EMajesty/dl4-mods/readme.md

# 📡 DL4 Mods 📡

<br>

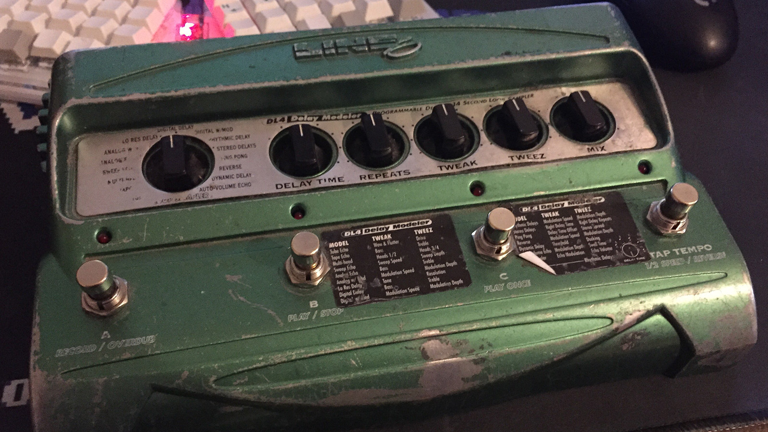
[picture p1: pictures/vanilla.jpg]
vanilla


<br>

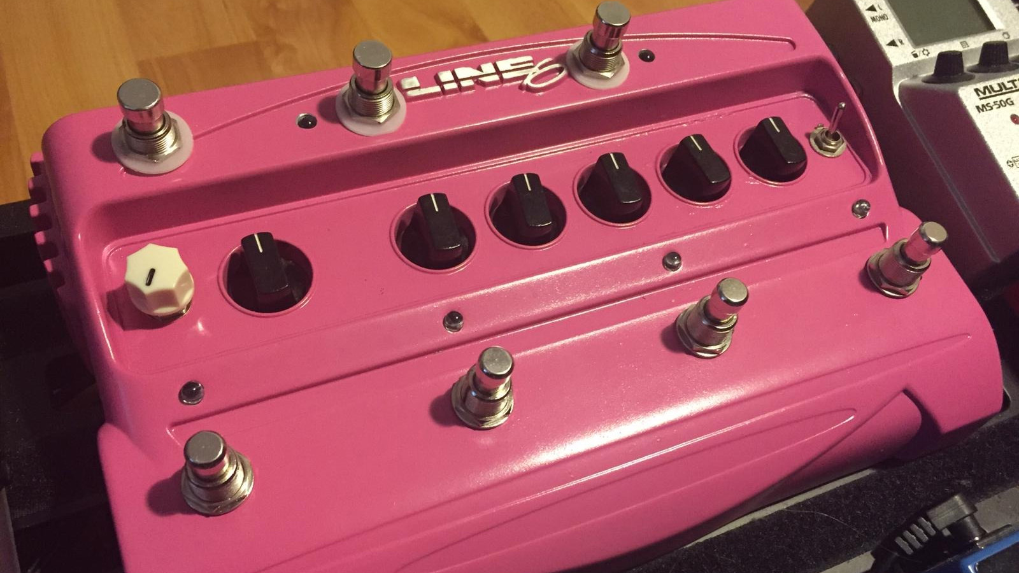
[picture p2: pictures/dl4.jpg]
dl4


<br>

# 🧨 Disassembly

<br>

Remove the potentiometer knobs by pulling or carefully prying with a flathead screwdriver.

Undo the jack nuts.

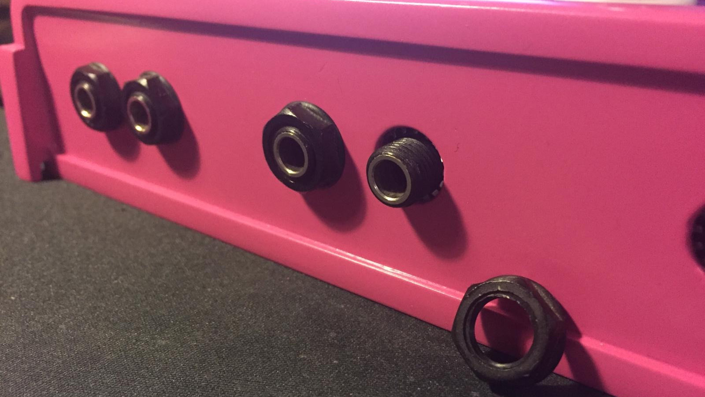
[picture p3: pictures/jacks.jpg]
jack nuts


Unscrew the five screws on the bottom.

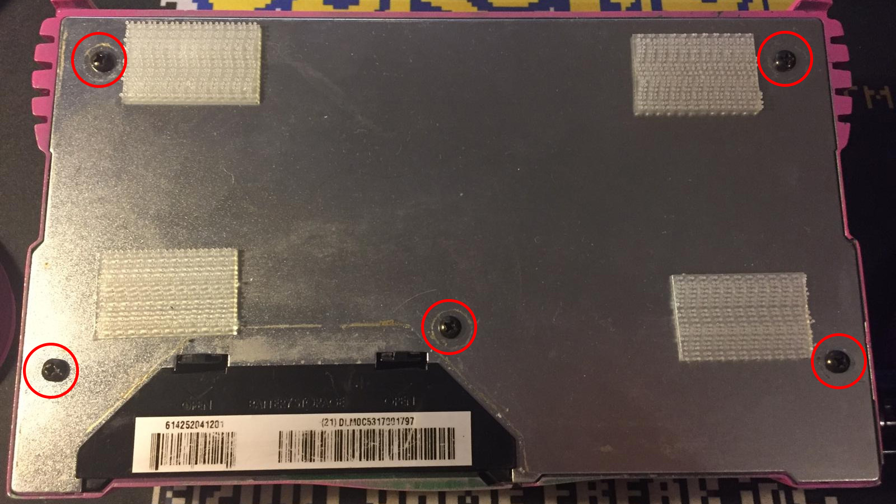
[picture p4: pictures/bottom.jpg]
bottom


Remove the four screws and the hex standoff.

Desolder the battery cables and remove the battery contacts to make room for the external tap tempo jack and the expression knob.

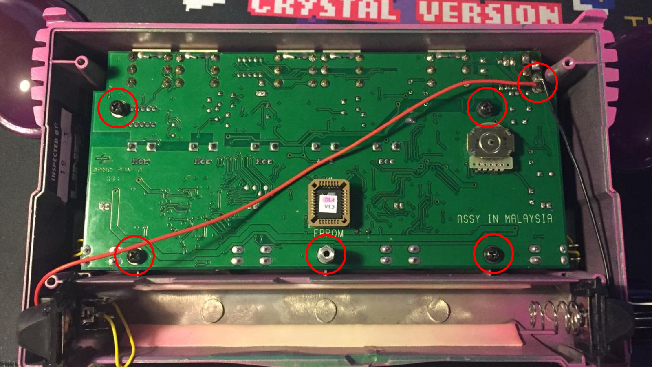
[picture p5: pictures/disassembly4.jpg]
dis4


Lift the PCB out by the front (standoff side) edge.

<br>

# 🔩 Switch Replacement

<br>

Replace the flimsy original switches with heavier duty ones.

<br>

| Parts needed | Qty |
| --- | --- |
| Momentary SPST footswitch | 4 |

<br>

Desolder or destroy the original tactile switches. Be careful not to lift a solder pad or cut a trace.

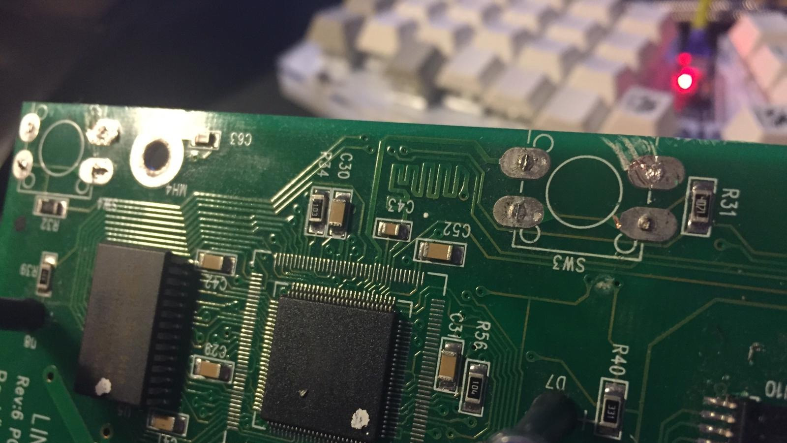
[picture p6: pictures/switches5.jpg]
fs


Remove the old switch bodies by undoing the nut on the outside.

Remove nubs in switch holes with e.g. a file, rotary tool or a 12mm / 1/2" drill bit.

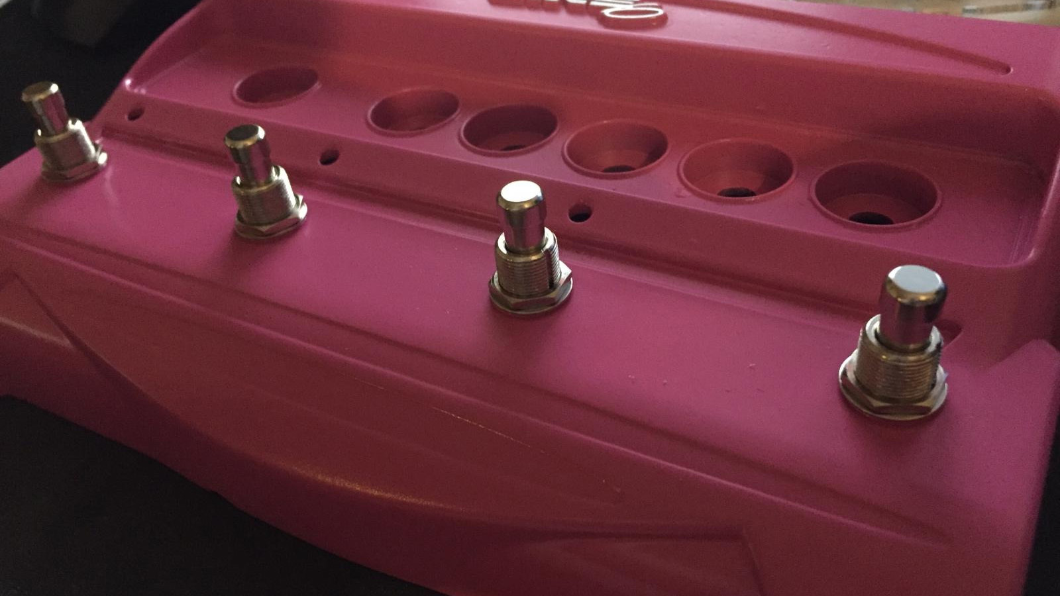
[picture p7: pictures/switches1.jpg]
switches1


Install the switches without the nut or washers on the inside.

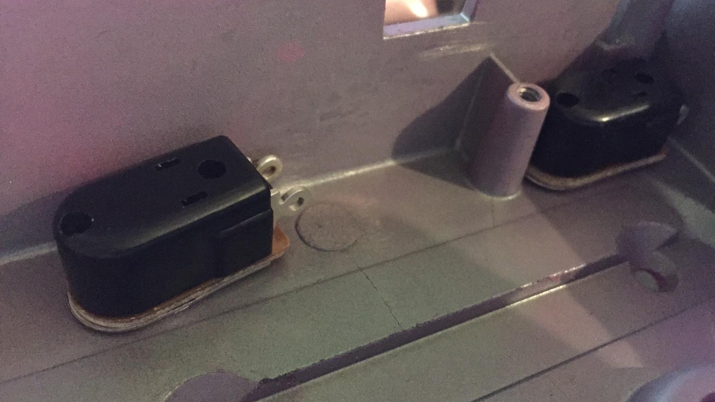
[picture p8: pictures/switches2.jpg]
switches2


Wire the new switches to the pads of the tactile switches, one wire on either of the top pads, one wire on a bottom pad. (The top pads are connected to each other and so are the bottom ones)

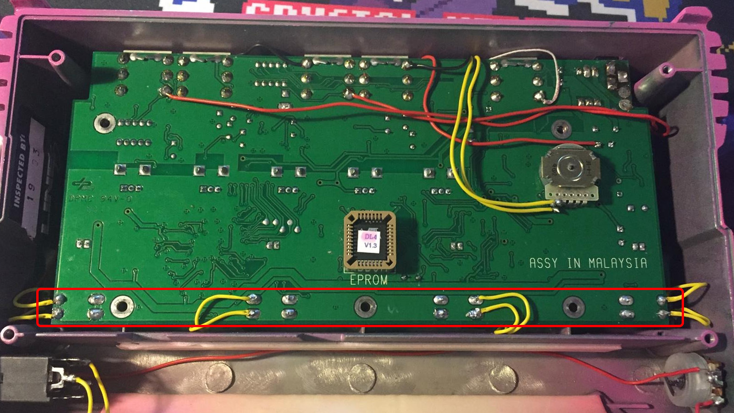
[picture p9: pictures/switches4.jpg]
sw4


<br>

# 💡 Led Replacement

| Parts needed | Qty |
| --- | --- |
| 3mm/5mm LEDs | 4 |

<br>

Desolder the old LEDs.

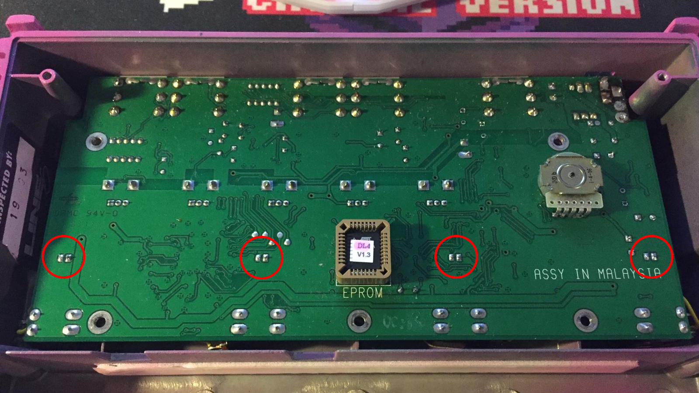
[picture p10: pictures/leds1.jpg]
leds1


Using the spacers from the old LEDs, install the new LEDs aligning the longer leg of the LED with the + on the PCB.

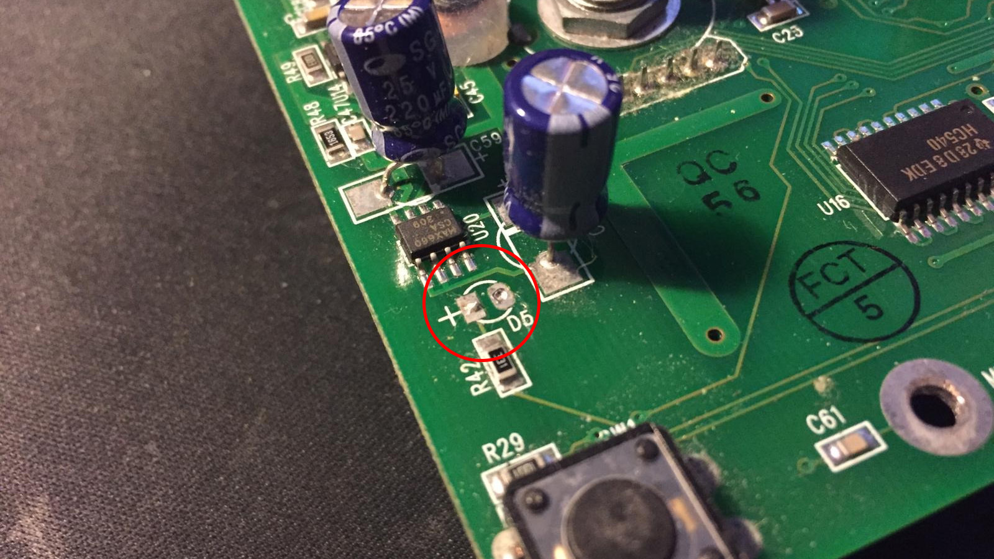
[picture p11: pictures/leds2.jpg]
leds2


If using 5mm LEDs you might have to drill the holes in the enclosure to match.

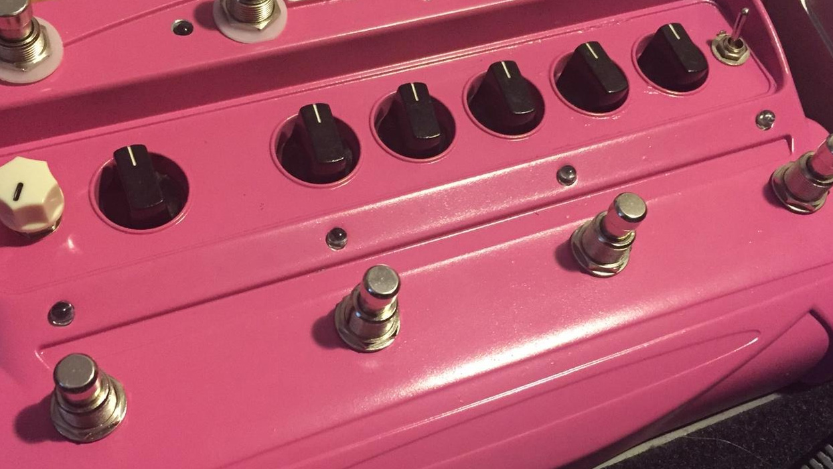
[picture p12: pictures/leds3.jpg]
leds3


<br>

# 📚 Double Presets Footswitch

[Source](https://www.diystompboxes.com/smfforum/index.php?topic=59261.0)

<br>

This mod adds a second set of presets by acting like an expression pedal in full heel or toe position.

<br>

| Parts needed | Qty |
| --- | --- |
| Latching DPDT footswitch | 1 |
| 10K resistor | 1 |

<br>

| Optional | Qty |
| --- | --- |
| LED | 1 |
| LED holder | 1 |

<br>

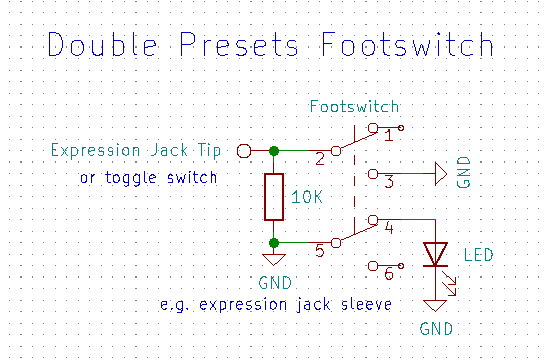
[picture p13: pictures/doublepresetschem.png]
doublepresetschem


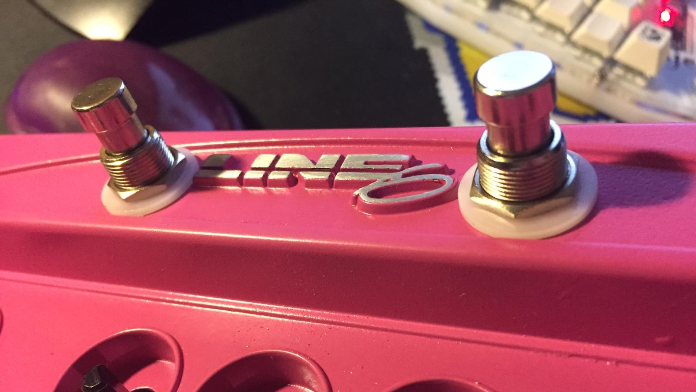
[picture p14: pictures/switches3.jpg]
switches3


Marking the holes is easier if you fit the white footswitch washer that comes with most 3PDT switches in the recess, then find the center. This way the switches shouldn't conflict with the jacks.

You might have to resolder C15 flat if it touches the switch.

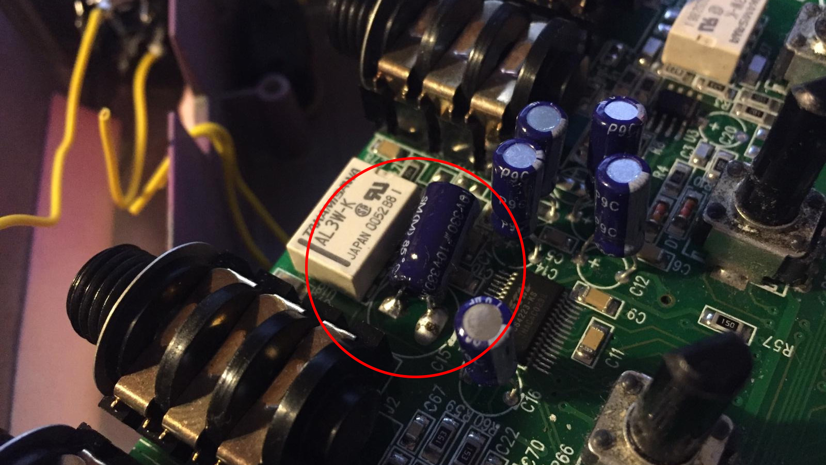
[picture p15: pictures/cap.jpg]
cap


Somebody somewhere said one should isolate the switching tip contact of the expression pedal jack, for example by sticking tape between the contacts. 

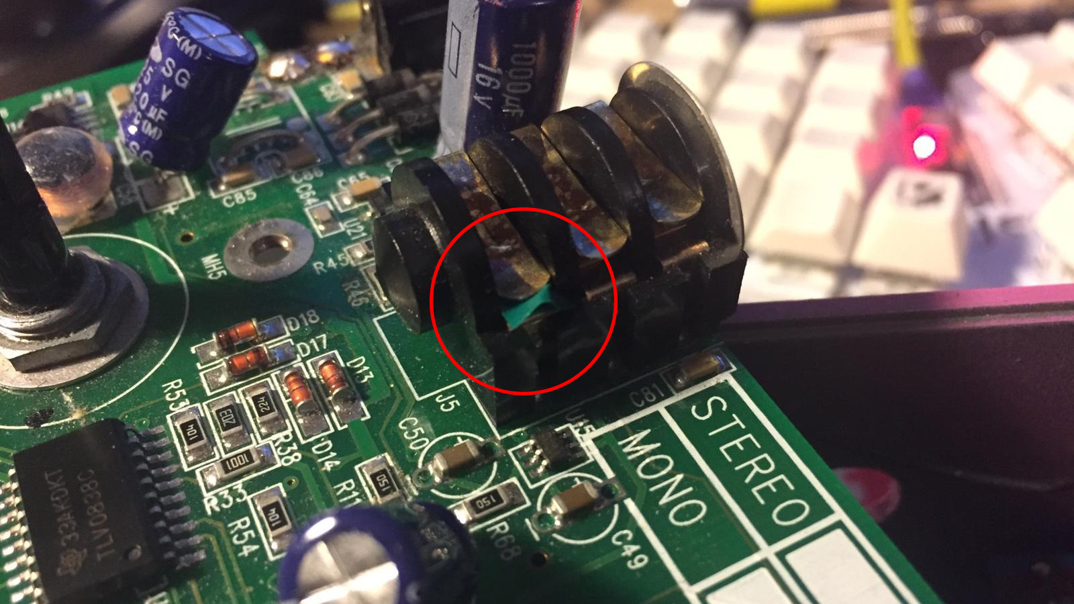
[picture p16: pictures/expisolate.jpg]
expisolate


If you're not using the toggle switch to choose between double presets / expression knob, solder the wire from the footswitch to the expression jack tip.

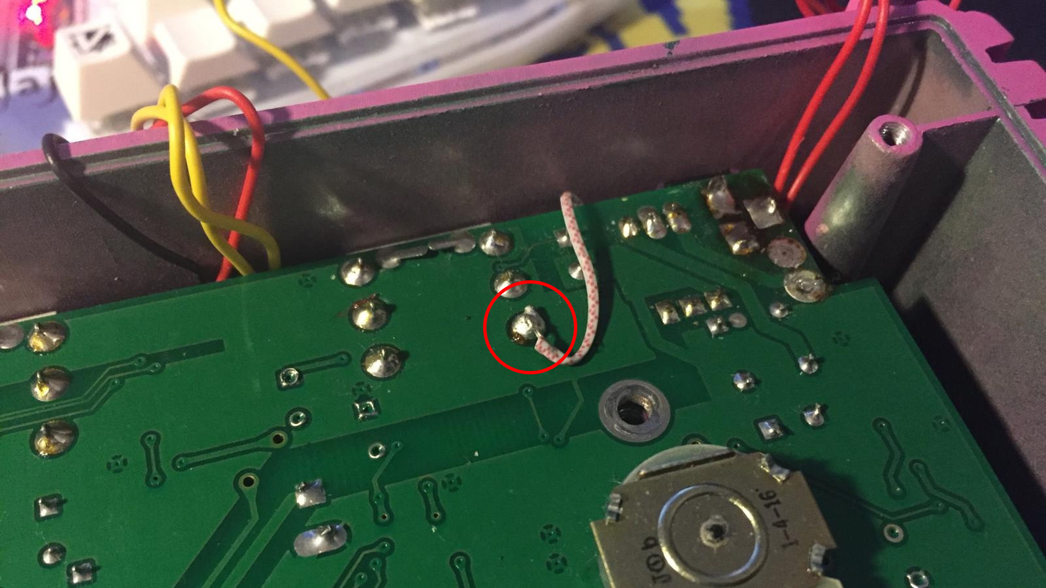
[picture p17: pictures/exptip.jpg]
exptip


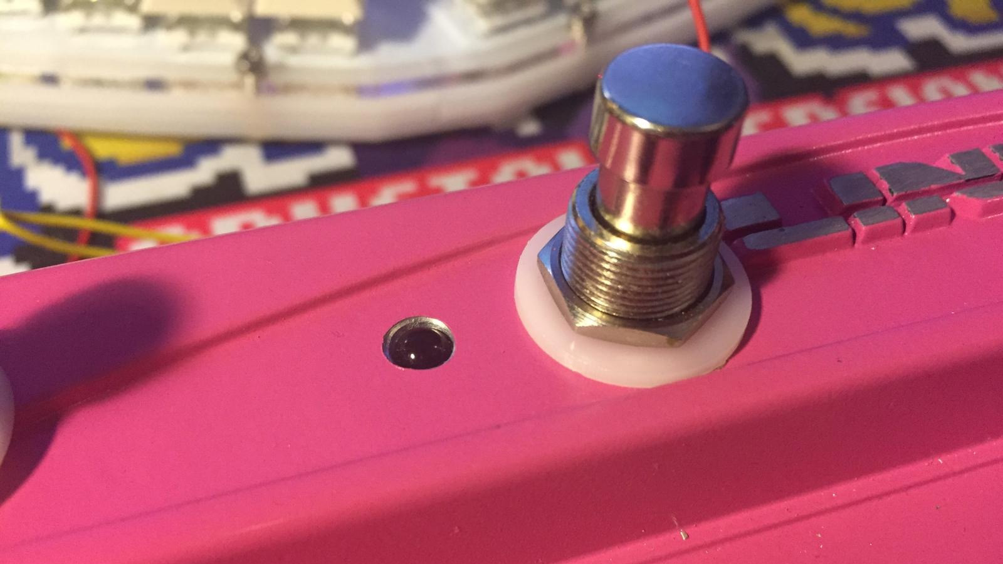
[picture p18: pictures/footled.jpg]
footled


You can solder the wire marked 'Expression Jack Sleeve' to any of these points.

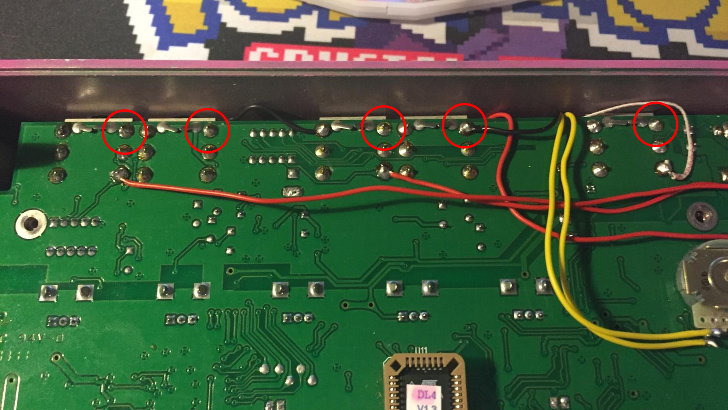
[picture p19: pictures/gnd.jpg]
gnd


<br>

# 💨 Expression Knob

[Source](https://web.archive.org/web/20201101212542/https://www.madbeanpedals.com/forum/index.php?topic=14394.msg134258)

<br>

The expression knob works like an external expression pedal would.

<br>

| Parts needed | Qty |
| --- | --- |
| 10K linear potentiometer | 1 |
| Potentiometer knob | 1 |

<br>

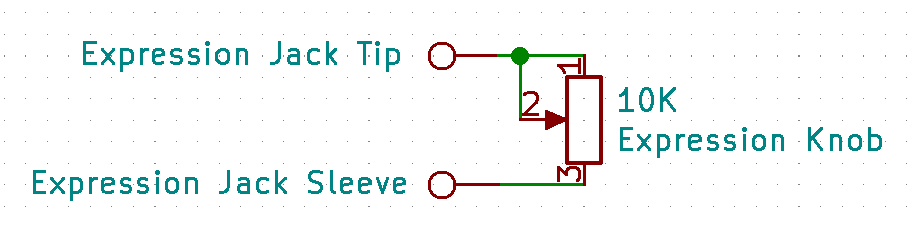
[picture p20: pictures/expressionknob.png]
expressionknob


Drill a hole for the potentiometer on an end of the battery bay approx. 20mm from the front edge and 18mm from the bottom, or whatever dimensions suit your knob.

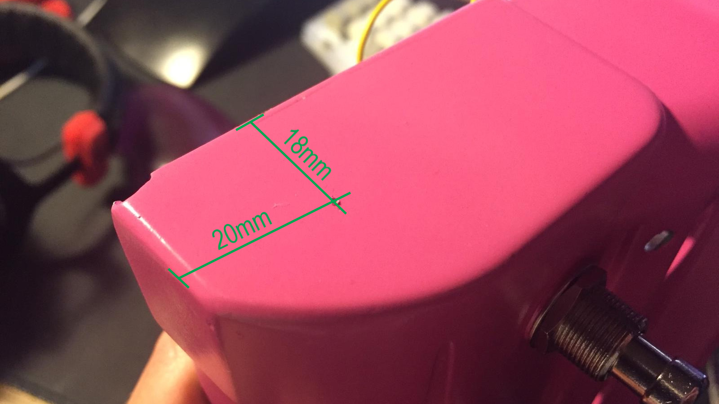
[picture p21: pictures/expknob1.jpg]
expknob


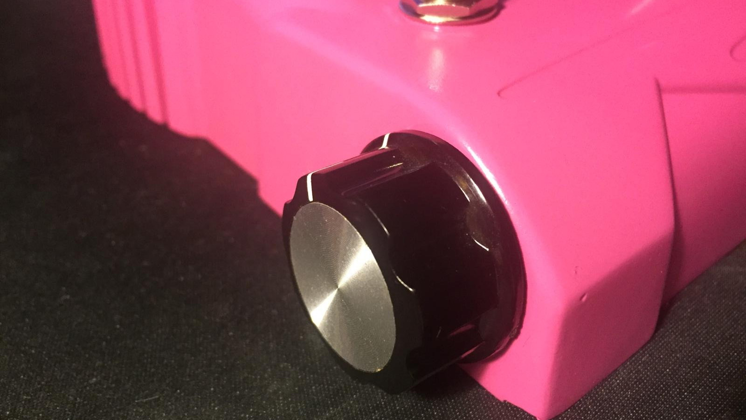
[picture p22: pictures/expknob2.jpg]
expknob2


Somebody somewhere said one should isolate the switching tip contact of the expression pedal jack, for example by sticking tape between the contacts. 

expisolate

If you're not using the toggle switch to choose between double presets / expression knob, solder the wire from the potentiometer to the expression jack tip.

exptip

You can wire the ground to a bottom pad of a switch.

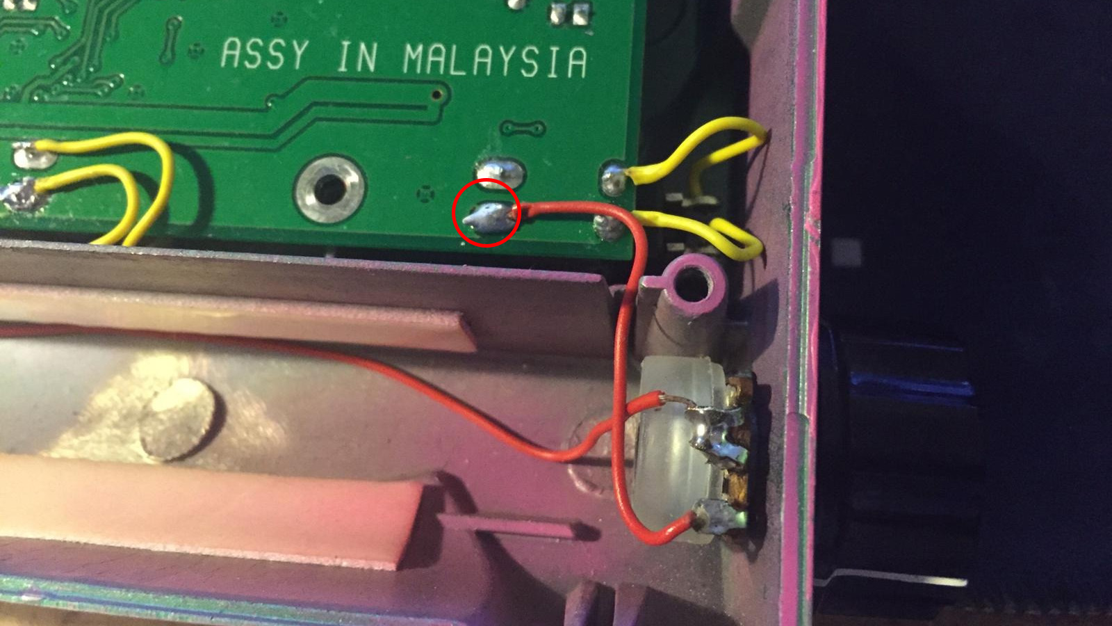
[picture p23: pictures/expknob3.jpg]
expgnd


<br>

# 💱 Switching between double presets and expression knob

<br>

| Parts needed | Qty |
| --- | --- |
| SPDT toggle switch | 1 |

<br>

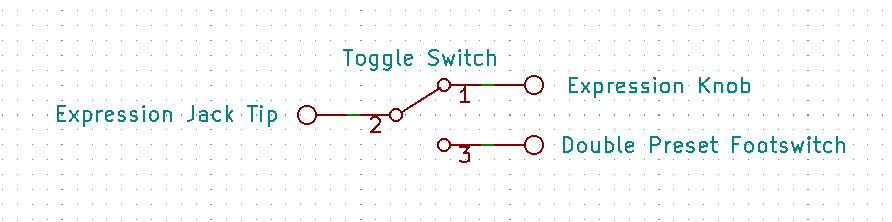
[picture p24: pictures/toggleschem.png]
toggleschem


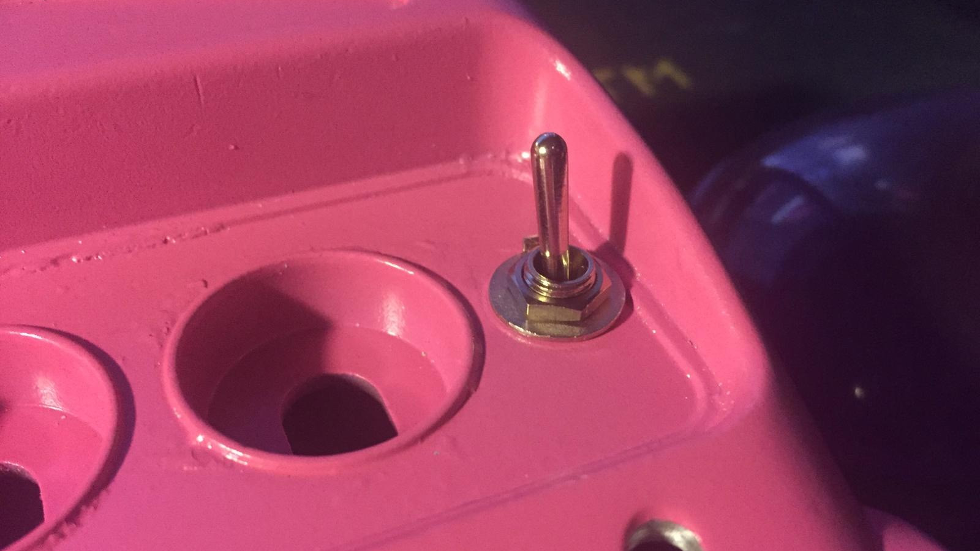
[picture p25: pictures/switch1.jpg]
switch1


Solder the wire from the toggle switch to the expression jack tip.

exptip

<br>

# 🎶 External Tap Tempo
[Source](https://web.archive.org/web/20110130235011/http://kyleagee.com/?page_id=105)

<br>

The external tap tempo jack allows you to connect a separate switch box via a cable.

<br>

| Parts needed | Qty |
| --- | --- |
| Mono jack | 1 |

<br>

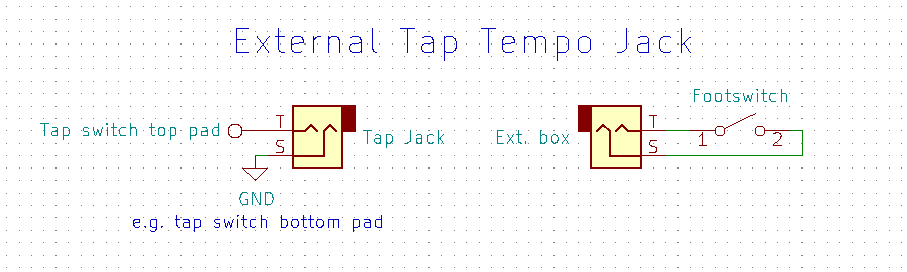
[picture p26: pictures/externaltap.png]
externaltap


Drill a hole for the jack on the end of the battery bay approx. 20mm from the front edge and 14mm from the bottom

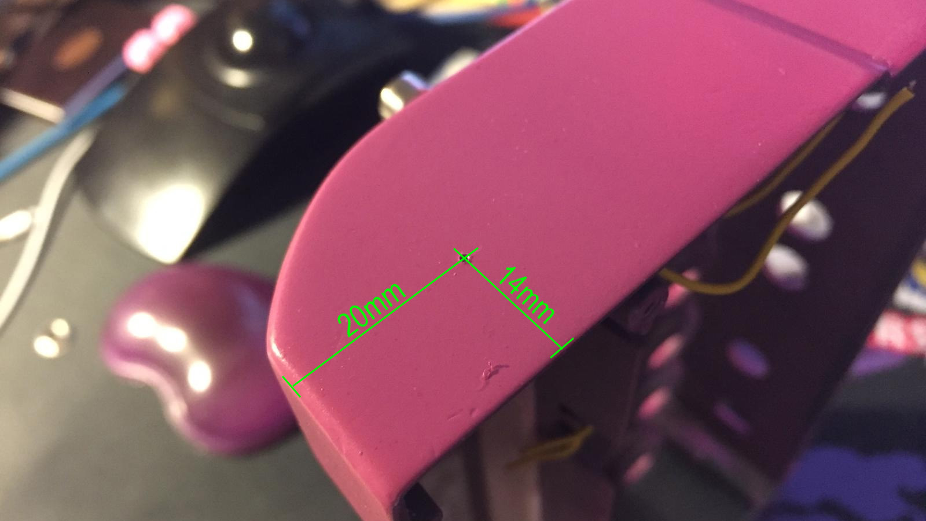
[picture p27: pictures/externaltap1.jpg]
exttap


The jack is installed parallel with the tap tempo switch, connecting the jack's tip to a top pad of the switch, sleeve on a bottom pad.

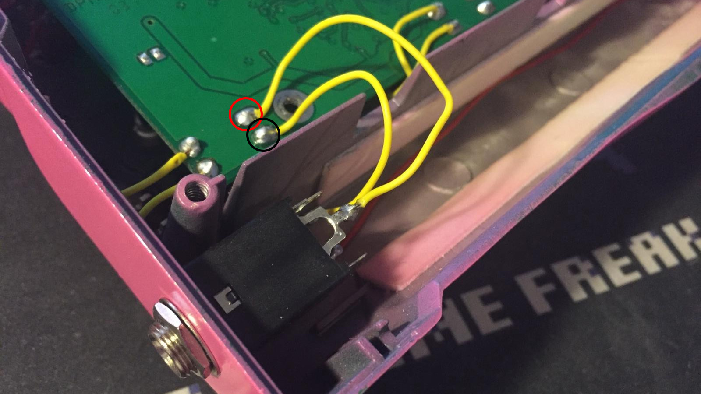
[picture p28: pictures/tapjack.jpg]
tapjack


<br>

# 💫 Feedback Loop
[Source](https://web.archive.org/web/20101130103726/http://experimentalistsanonymous.com/board/index.php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)

<br>

This mod adds a footswitchable feedback loop with an optional potentiometer in series to control the amount of feedback.

<br>

| Parts needed | Qty |
| --- | --- |
| Momentary or latching SPST footswitch | 1 |

| Optional | Qty |
| --- | --- |
| 250K potentiometer | 1 |
| 68K resistor | 1 |
| Potentiometer knob | 1 |

<br>

The resistor is there to make the whole range of the potentiometer more usable. The values are a bit arbitraty but seem to work.

<br>

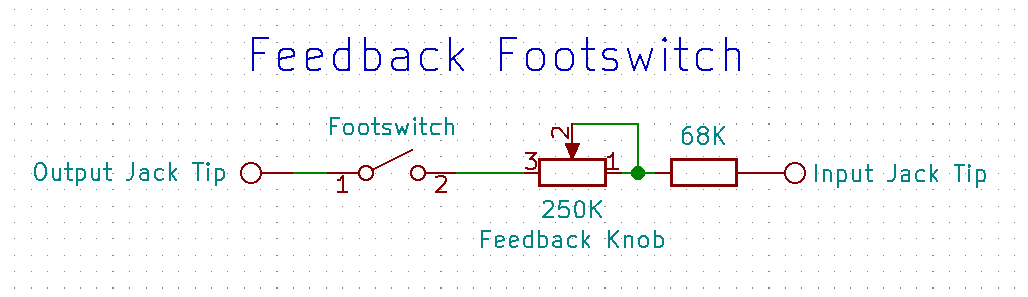
[picture p29: pictures/feedbackschem.png]
feedbackschem


You can barely fit another footswitch above the power jack. Below it is a nice spot for the feedback amount potentiometer if you don't mind a hole in the preset texts.

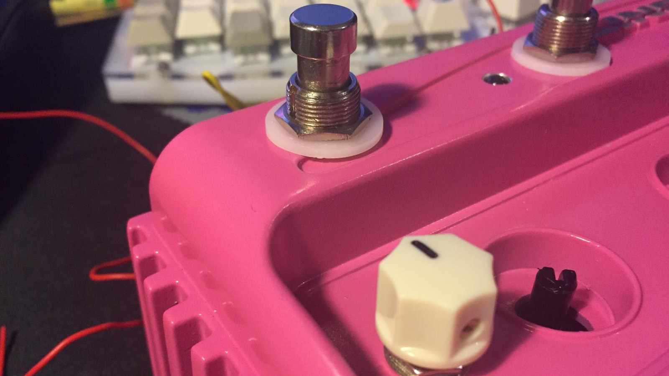
[picture p30: pictures/feedback1.jpg]
feedback


Here the wires are soldered to the left input jack tip and the left output jack tip.

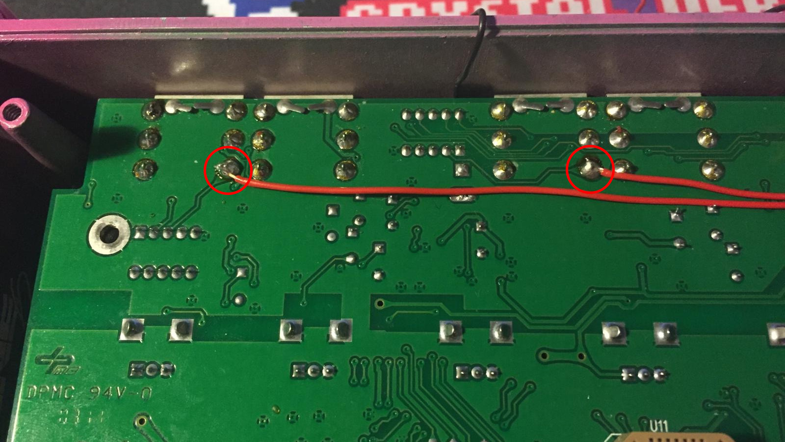
[picture p31: pictures/feedback2.jpg]
fb2


<br>

# 🔊 Volume Drop Fix
[Source](https://web.archive.org/web/20201027203217/https://www.harmonycentral.com/forums/topic/119557-line-6-mm4dl4-volume-fix-without-using-smt-resistors/)

<br>

Some people experience a problem with volume drop. This mod increases the gain of the output buffers fixing the issue.

<br>

| Parts needed | Qty |
| --- | --- |
| 22K-24K resistor | 2 |
| or |
| 56K-68K resistor | 2 |

<br>

Either remove R36 and R37 and replace with 22K-24K resistors, or solder 56K-68K resistors parallel to the original resistors.

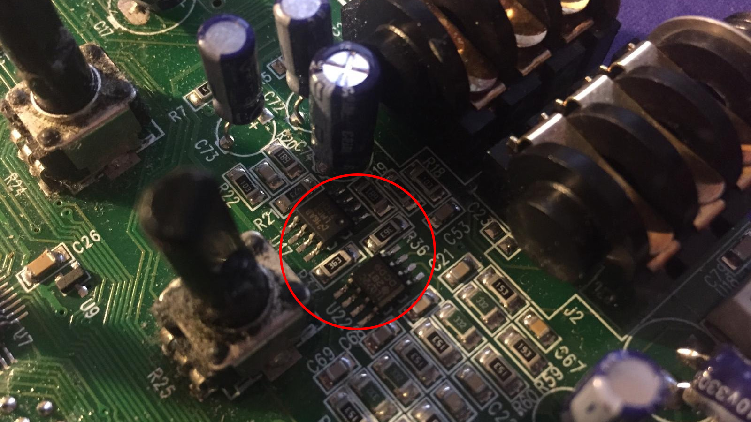
[picture p32: pictures/resistors1.jpg]
resistors1


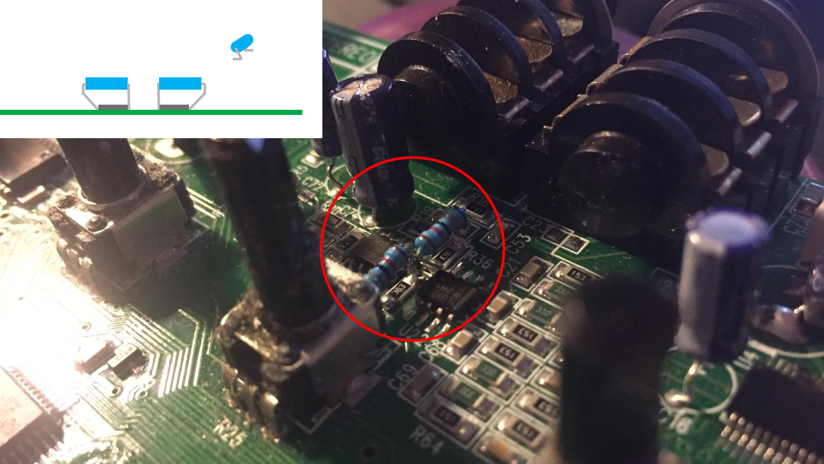
[picture p33: pictures/resistors2.jpg]
resistors2


<br>

# ⭕ Looper Shortcut Footswitch
[Source](https://web.archive.org/web/20200301050201/http://www.pedalhaven.com/line-6-dl4-mods-looper-switch/)

<br>

The looper shortcut footswitch allows you to switch between the delay and the looper setting via a footswitch.

<br>

| Parts needed | Qty |
| --- | --- |
| Latching DPDT footswitch | 1 |

| Optional | Qty |
| --- | --- |
| LED | 1 |
| LED holder | 1 |

<br>

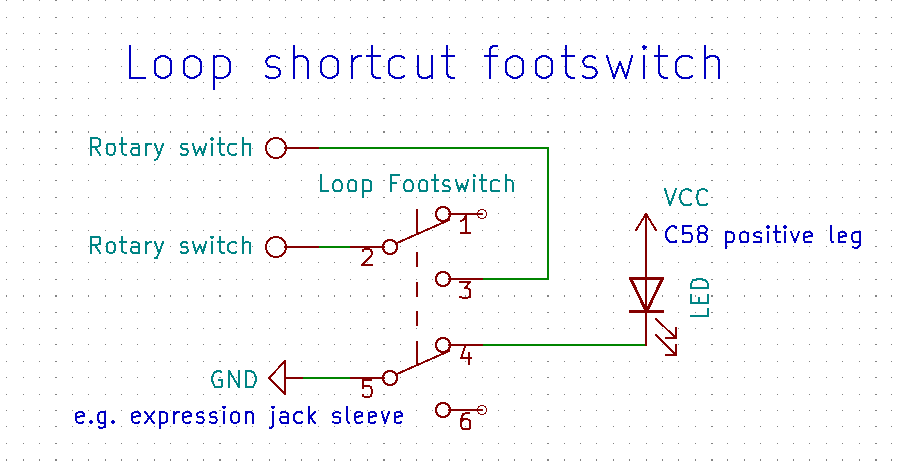
[picture p34: pictures/loopswitchschem.png]
loopschem


Cut the leftmost leg in the middle and bend the remaining stubs outward.

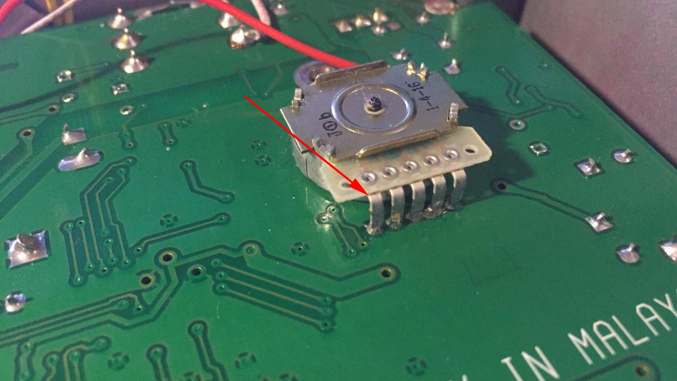
[picture p35: pictures/looppin1.jpg]
looppin1


Solder the wires from the footswitch to each end of the cut rotary switch leg.

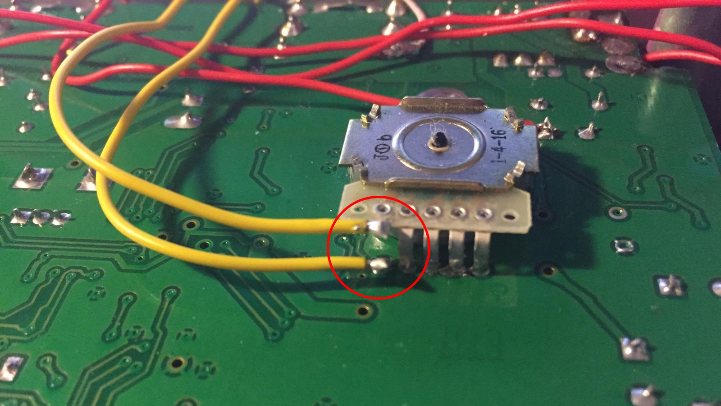
[picture p36: pictures/looppin2.jpg]
looppin2


We can tap into the 3.3V rail from the positive leg of C58 to power the LED.

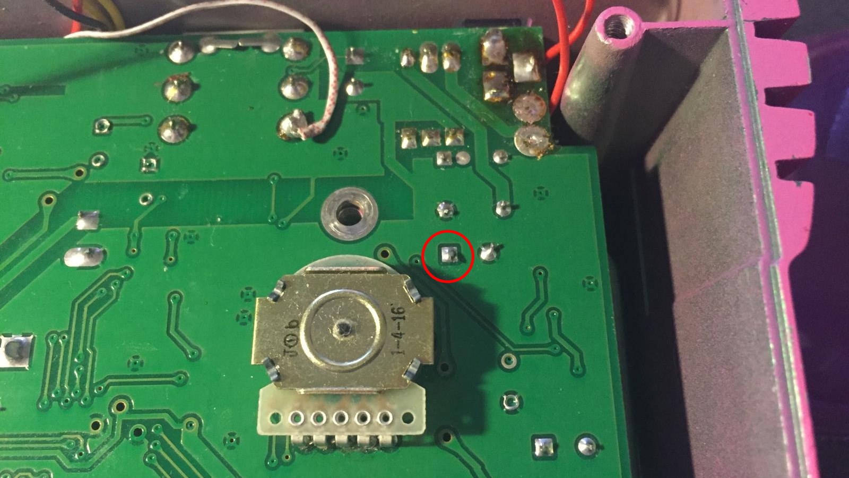
[picture p37: pictures/loopledpower.jpg]
ledpower


Red is LED's positive wire, black is negative and goes to the switch.

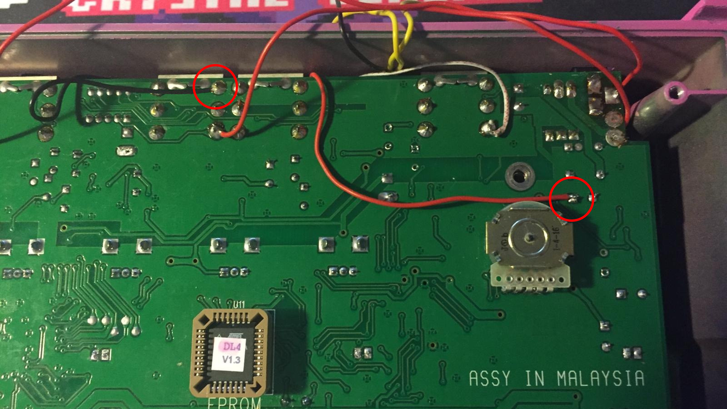
[picture p38: pictures/loopledpower2.jpg]
ledpower2


footled
