EMajesty/dl4-mods/mods.sch

## KiCad design mods.sch (2020-11-01)

Schematic: mods.sch

Parts:
10K: Expression Knob
250K: Feedback Knob

Notes on the sheet:
Feedback Footswitch
Switch between double presets and expression knob
Double Presets Footswitch
Expression Knob
External Tap Tempo Jack
e.g. expression jack sleeve or footswitch bottom pad
e.g. tap switch bottom pad
e.g. expression jack sleeve
or toggle switch
Loop shortcut footswitch
C58 positive leg
